SvOlli/USB2Amiga/images/dev_board.jpg

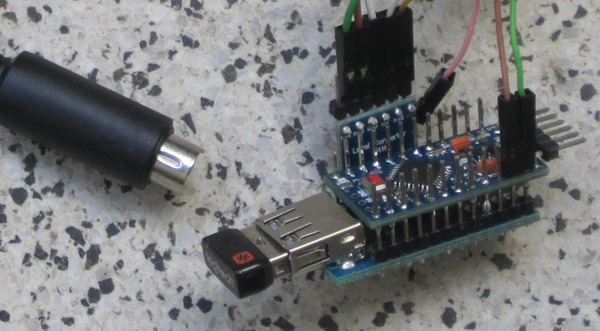
images/dev_board.jpg
