SvOlli/USB2Amiga/hex/build_info.txt

These builds were done using the "arduino-mk" package on the following system:
Distributor ID:	Debian
Description:	Debian GNU/Linux 9.13 (stretch)
Release:	9.13
Codename:	stretch
Build run completed at: Thu Nov  4 18:41:58 UTC 2021
