SvOlli/USB2Amiga/(threads)

Thread 1 (2021-03-26):

Wiring up the Arduino with the level shifter

rayrayrayraydog, 2021-03-26:
Hi,

I'm working to build this adapter for an Amiga 1000 (possibly the first one?).  I'm just having a bit of trouble following how you've wired up the level shifter in your pictures.  Can you help with some higher res photos or more clear docs in the project?

Thanks.

rayrayrayraydog, 2021-04-01:
Ah, nevermind.  I finally got the keyboard input working with my A1000 today using DB9.ino.

SvOlli, 2021-05-07:
Dang!

Something seems to be wrong with my email notification, as I just noticed this ticket by accident. Sorry.

Also sorry about the confusion with the level shifters. With my incarnations of this project I tend to not use them anymore.

This is also because the software takes open collector into account: the "1" signal is done by putting the pin into input mode, only for the "0" the ATmega is put into output mode. Having more the 4.3V at an input pin is outside of the specification of the Arduino, but my current setup for the CDTV is now running for about a year without any problems being used regularly, being powered all of the time, since I want to turn the CDTV on via keyboard.

May I quote you on the main page for a successful build of the A1000 variant?

rayrayrayraydog, 2021-05-07:
Yes you may, but I'm still working on some kinks with the keyboard input.
I was able to get the mouse fully working without the level shifter, but
for the keyboard data pins it seems to be a requirement.  The keyboard
performance is not perfect -- keypresses are occasionally missed and things
go haywire if I start to type too fast.  After consulting with someone with
more experience I guess I need to filter line noise with some pull up (or
down) resistors, but haven't figured it out yet.

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

rayrayrayraydog, 2021-05-07:
Sounds good.  I have a second build mostly complete on a breadboard, I will remove the level shifter and give this a try over the next couple days.  Thanks!

Closed 2021-04-01.

Thread 2 (2022-04-18):

CDTV Using a Arduino UNO instead Arduino pro mini

Geppo3D, 2022-04-18:
Why is not possible to use Arduino UNO? The output from CDTV is 5v

SvOlli, 2022-06-19:
Sorry for the late response, I never got a notification.
To the question at hand: the 3.3v are required for the USB host shield. As stated on https://www.shop.tkjelectronics.dk/product_info.php?products_id=45 :

> This shield only work with Arduino Pro Mini boards, running at 3.3V-only.

Looking at the data-sheet for the chip used (MAX3421E) https://www.maximintegrated.com/en/products/interface/controllers-expanders/MAX3421E.html , it's also stated there, that the chip requires 3.3v and this includes 3.3v for data lines as well.

OleUrgast, 2022-10-14:
There are also USB-host-shields for Arduino Uno and Mega. These shields already contain level converters between USB-chip and connector to the UNO onboard, as Uno and Mega allways have 5 V. So it should work and be even simplier to build (headers already soldered; only think to solder are the connectors). https://youtu.be/EpXxh4k4NW8 As far as I know, no difference softwarewise between the 5V USB-hostshield for UNO/Mega and the 3,3V USB-hostshield for 3.3V nano/micro pro, so it should work...

On the other hand the adapter would become very big, using full size UNO and USB-host shield. Also it is a bit more expensive. Of course, if you already have an old UNO and USB-hostshield flying around from old projects, it might be worth giving a try (esp. as chip-crisis increase price and reduce availibility at the moment).

Thread 4 (2023-05-04):

Amiga 600/1200 can work in theory

meup, 2023-05-04:
I just wanted to point out that for the Amiga 600 and 1200, where the keyboard controller is located on the motherboard, they still talk to the 8520 I/O chip just like on the other models.  All that's necessary to attach this adapter is to connect to the right places on the motherboard.

For the Amiga 600, you can connect:
KB_DATA: pin 43 of U7, pin 43 of U13, or R511B (bottom of board)
KB_CLOCK: pin 44 of U7, pin 41 of U13, or R511A (bottom of board)
If you connect to the resistors, find the side that isn't connected to 5V (probably side away from serial port, but check).
KB_RESET: not as clear cut: maybe R624 (if unpopulated), side which connects to pin 2 of U14 (or that same pin)
 or use 511D (bottom of board), side that is not connected to 5V (check).
On the 600 (some revisions), reset is generated directly from the keys, but it triggers the U14 555 timer

For the Amiga 1200, there is:
KB_DATA: pin 43 of U7, pin 13 of U13, or R511B (bottom of board)
KB_CLOCK: pin 44 of U7, pin 14 of U13, or R511A (bottom of board)
On the A1200, it looks like the side of the resistors closer to the parallel port is the side to use, but check.
KB_RESET: R626 or R623 (bottom of board), side that is not VCC or GND (maybe side away from audio jacks, but check).

Some models of A1200 actually have a keyboard serial connector, CN17, where:
- pin 1: KB_DATA
- pin 2: KB_CLOCK
- pin 3: KB_RESET
- pin 4: reset to keyboard controller?
- pin 5: NC
- pin 6: Vcc
- pin 7: Gnd

All this info is from the Amiga 600 and 1200 schematics, which you can find online.

meup, 2023-12-26:
Just a note that I've finally verified this works with the Amiga 600.
The pictures show the connections:
red: 5V (from floppy drive power connector)
brown: Gnd (from floppy drive power connector)
orange: KB_DATA (resistor R511B)
green: KB_CLOCK (resistor R511A)
yellow: KB_RESET (resistor R624, not populated)
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

Thread 6 (2025-05-30):

A3000 mouse and keyboard adapters dont seem to function

marcocet, 2025-05-30:
Hello! if you happen to see this is there any chance you would be able to help me out?

I recently built two separate adapters, for mouse and keyboard for my A3000 and cant seem to get either to work.

Ensured all my wiring is correct, and hooked up to the serial terminal on the pro mini to see if there was anything useful in the output sense in the code i saw that it writes to serial but got nothing.
