SvOlli/USB2Amiga/(commit log)

2020-07-14 - release build architecture added - updated documentation - fixed compiler warnings
    [config.h]
2020-07-18 added a quick hack to be able to send CDTV remote's "power" key using SysRq
2020-07-20 major rework on the code to get a modular approach to reuse code in various build configurations like CDTV, Amiga DB9 mouse, etc.
    [CDTV.ino]
2020-08-06 ARRGGHH!! pin 9 is also used by the USB host shield. This collides with the right mouse button pin. The later one had to be moved to pin A0. D'oh!
    [config.h, gpio.h]
2021-03-04 fixed typo: INSERT was mapped to CS<- instead of HELP
2021-03-28 re-added USB hub support in so if an update to the library fixes the problem, it will be integrated magically just by recompiling
    [CDTV.ino, DB9.ino]
